lhovo/Netrol/Documents/Bill of Materials-NetTroll.xlsx

Comment | Description | Designator | Footprint | LibRef | Quantity | Manufacturer Part Number 1 | Supplier 1 | Supplier Part Number 1 | Supplier Stock 1 | Supplier Unit Price 1
NUF2230XV6T1G | 2 Line EMI Filter with ESD Protection, -40 to 85 degC, 6-Pin SOT-563, Pb-Free, Tape and Reel | U8, U9 | ONSC-SOT-563-6-463A-01_V | CMP-1066-00031-1 | 2 | NUF2230XV6T1G | Digi-Key | NUF2230XV6T1GOSDKR-ND | 2737 | 0.2728
ATmega328P-MUR | 8-bit AVR Microcontroller, 32KB Flash, 1KB EEPROM, 2KB SRAM, 32-pin MLF, Industrial Grade (-40°C to 85°C) | U1 | 32M1-A_N | ATmega328P-MUR | 1 | ATMEGA328P-MUR | Digi-Key | ATMEGA328P-MURCT-ND | 7953 | 3.445
NUF8402MNT4G | 8-Channel EMI Filter with Integrated ESD Protection, -40 to 85 degC, 16-Pin DFN, Pb-Free, Tape and Reel | U5, U6 | ONSC-DFN-16-506AC_V | CMP-1009-00001-1 | 2 | NUF8402MNT4G | Digi-Key | NUF8402MNT4GOSCT-ND | 1148 | 0.4092
Buck Converter | Adjustable Buck Converter Module | U7 | Buck_Module | Buck | 1
10pF | Capacitor (Semiconductor SIM Model) | C1, C2, C12, C13 | 0603 | Cap_10pF | 4 | CL10C100JC8NNNC | Digi-Key | 1276-2157-1-ND | 10504 | 0.0088
100nF | Capacitor (Semiconductor SIM Model) | C3, C4, C5, C6, C7, C8, C17, C18, C19, C20 | 0603 | Cap_100pF, Cap_100pF, Cap_100pF, Cap_100pF, Cap_100pF, Cap_100pF, Cap_100nF, Cap_100pF, Cap_100pF, Cap_100nF | 10 | C0603C104K4RACTU | Digi-Key | 399-1096-1-ND | 2381401 | 0.0101, 0.0101, 0.0101, 0.0101, 0.0101, 0.0101, 0.0156, 0.0101, 0.0101, 0.0156
4.7uF | Capacitor (Semiconductor SIM Model) | C10 | 0603 | Cap_4.7uF | 1 | CL10B475KQ8NQNC | Digi-Key | 1276-2087-1-ND | 73430 | 0.074
10nF | Capacitor (Semiconductor SIM Model) | C11, C16 | 0603 | Cap_10nF | 2 | C0603C103K5RACTU | Digi-Key | 399-1091-1-ND | 1564655 | 0.014
6.8nF | Capacitor (Semiconductor SIM Model) | C14, C15 | 0603 | Cap_6.8nF | 2 | CL10B682KB8SFNC | Digi-Key | 1276-2103-1-ND | 38764 | 0.0068
22uF | Capacitor (Semiconductor SIM Model) | C21 | 1210 | Cap_22uF | 1 | LMK325F226ZN-T | Digi-Key | 587-1395-1-ND | 9011 | 0.374
10uF | Capacitor (Semiconductor SIM Model) | C22, C23, C24 | 0603 | Cap_10uF | 3 | C1608X5R1E106M080AC | Digi-Key | 445-9015-1-ND | 130756 | 0.757
Diode | Default Diode | D4, D7, D9 | SOD-123 | Diode | 3 | MBRX120LF-TP | Digi-Key | MBRX120LF-TPMSCT-ND | 22264 | 0.2836
SMAJ58CA-TR | Default Diode | D8 | SMBJ | Diode_POWER | 1 | SMAJ58CA-TR | Digi-Key | 497-6509-1-ND | 11568 | 0.434
HD01-T | Diode Bridge | D1, D2 | MBS | Diode Bridge | 2 | HD01-T | Digi-Key | HD01DICT-ND | 89962 | 0.31
RJHSE-5384 | Ethernet Socket RJ45 With Leds | JP1 | RJHSE-5484 | Ethernet Socket | 1 | RJHSE-5384 | Digi-Key | RJHSE-5384-ND | 967 | 1.764
MMZ1608F030B | Ferrite Bead | FB1, FB2 | 0603 | Ferrite Bead | 2 | MMZ1608F030B | Digi-Key | 445-8676-1-ND | 14689 | 0.087
12V In/Out | Header, 2-Pin | JP4 | SCREWTERMINAL-3.5MM-2 | Header 2_ST | 1 | 1776275-2 | Digi-Key | A98036-ND | 49006 | 0.498
Common/NC | Header, 2-Pin | JP6 | SCREWTERMINAL-3.5MM-2 | Header 2_ST | 1 | 1776275-2 | Digi-Key | A98036-ND | 49006 | 0.498
GND/NO | Header, 2-Pin | JP8 | SCREWTERMINAL-3.5MM-2 | Header 2_ST | 1 | 1776275-2 | Digi-Key | A98036-ND | 49006 | 0.498
Selectable interrupt Via solder bridge | Header, 2-Pin | JP9 | SCREWTERMINAL-3.5MM-2 | Header 2_ST | 1 | 1776275-2 | Digi-Key | A98036-ND | 49006 | 0.498
Main Interrupt | Header, 2-Pin | JP12 | SCREWTERMINAL-3.5MM-2 | Header 2_ST | 1 | 1776275-2 | Digi-Key | A98036-ND | 49006 | 0.498
Relay Voltage Jumper | Header, 3-Pin | JP5 | 1X3 | Header 3 | 1 | M20-9990346 | Digi-Key | 952-2264-ND | 5963 | 0.132
Programming FTDI Header | Header, 6-Pin | JP2 | 1X6 | Header 6 | 1 | M20-9990646 | Digi-Key | 952-2270-ND | 6823 | 0.214
Optional External LED's | Header, 8-Pin | JP3 | 2X4 | Header 4x2 | 1 | M20-9760446 | Digi-Key | 952-1788-ND | 1636 | 0.28
Optional I/O | Header, 10-Pin, Dual row | JP7 | 2X10 | Header 10X2 | 1 | 302-S201 | Digi-Key | ED10524-ND | 509 | 0.42
TPS62112RSAT | IC REG BUCK SYNC 5V 1.5A 16QFN | U4 | 16-QFN | TPS62112RSAT | 1 | TPS62112RSAT | Digi-Key | 296-19717-1-ND | 11224 | 3.483
6.8uH | INDUCTOR WW 6.8UH 1.1A 1812 SMD | L1 | 1812 | INDUCTOR | 1 | LQH43CN6R8M03L | Digi-Key | 490-2518-1-ND | 304 | 0.426
10K | Isolated Resistor Network - Parts | R1, R3, R7 | SO8_S | Resistor_Pack_10K | 3 | 742C083103JP | Digi-Key | 742C083103JPCT-ND | 56827 | 0.069
100R | Isolated Resistor Network - Parts | R15 | SO8_S | Resistor_Pack_100R | 1 | 742C083101JP | Digi-Key | 742C083101JPCT-ND | 69745 | 0.069
BCX19 | NPN General Purpose | Q1 | SOT23-3 | BCX19 | 1 | BCX19LT1G | Digi-Key | BCX19LT1GOSCT-ND | 9124 | 0.207
AG8112 | POE Controller and Buck Converter | U3 | AG8100 | AG8100 | 1 | AG8112 | Fairmont Marketing | AG8112 | 5000 | 7.50
100uF | Polarized Capacitor (Surface Mount) | C9, C26 | PANASONIC_C | Cap_Polarized_100uF | 2 | EEE-HAJ101WAR | Digi-Key | PCE4718CT-ND | 2897 | 0.56
1000uF | Polarized Capacitor (Surface Mount) | C25 | PANASONIC_H13 | Cap_Polarized_1000uF | 1 | EEV-FK1E102Q | Digi-Key | PCE3462CT-ND | 361872 | 1.61
H2019FNLT | Power over Ethernet Magnetic Module | T1 | HXXXX | Magnetics | 1 | H2019FNLT | Mouser | 673-H2019FNLT | 610 | 7.51
LED-RGB_K | RED, GREEN, BLUE LED | D6 | RGB-CLVBAFKA | LED-RGB_K | 1 | CLVBA-FKA-CAEDH8BBB7A363 | Digi-Key | CLVBA-FKA-CAEDH8BBB7A363CT-ND | 11711 | 0.55
1M | Resistor | R2, R6, R20 | 0603 | Resistor_1M | 3 | AF0603FR-071ML | Digi-Key | 311-1MLMCT-ND | 4590 | 0.054
12K4 | Resistor | R4 | 0603 | Resistor_12K4 | 1 | RC1608F1242CS | Digi-Key | 1276-4752-1-ND | 1263 | 0.014
10K | Resistor | R5, R19, R21 | 0603 | Resistor_10K | 3 | RC0603JR-0710KL | Digi-Key | 311-10KGRCT-ND | 3996732 | 0.008
82R | Resistor | R8, R9 | 0603 | Resistor_82R | 2 | RC0603JR-0782RL | Digi-Key | 311-82GRCT-ND | 8364 | 0.008
10R | Resistor | R10 | 0603 | Resistor_10R | 1 | RC1608J100CS | Digi-Key | 1276-5014-1-ND | 189294 | 0.10
49R9 | Resistor | R11, R12 | 0603 | Resistor_49R9 | 2 | MCR03ERTF49R9 | Digi-Key | RHM49.9CFCT-ND | 136578 | 0.0084
220R | Resistor | R13, R14 | 0603 | Resistor_220R | 2 | RC0603JR-07220RL | Digi-Key | 311-220GRCT-ND | 771266 | 0.008
470R | Resistor | R22 | 0603 | Resistor_470R | 1 | RC0603JR-07470RL | Digi-Key | 311-470GRCT-ND | 668174 | 0.011
4K7 | Resistor | R23 | 0603 | Resistor_4K7 | 1 | RC0603JR-074K7L | Digi-Key | 311-4.7KGRCT-ND | 4295372 | 0.011
G5V-1-DC12 | Single-Pole Dual-Throw Relay | K1 | G5V-1 | Relay-SPDT | 1 | G5V-1-DC12 | Digi-Key | Z774-ND | 18767 | 2.05
16MHz | Surface Mount Quartz Crystal | Y1 | CRYSTAL-SMD-2.5X2-ABM10 | Crystal_16MHz | 1 | CX2520DB16000D0GEJCC | Digi-Key | 1253-1122-1-ND | 0 | 0.774
25MHz | Surface Mount Quartz Crystal | Y2 | CRYSTAL-SMD-2.5X2-ABM10 | Crystal_25MHz | 1 | ABM10-25.000MHZ-E20-T | Digi-Key | 535-9095-1-ND | 10901 | 1.469
EVQ-Q2B03W | Switch | S1 | TACTILE_SWITCH_SMD | SW-PB | 1 | EVQ-Q2B03W | Digi-Key | P12932SCT-ND | 18730 | 0.374
LED | Typical RED, GREEN, YELLOW, AMBER GaAs LED | D3, D5 | LED-0603 | LED | 2 | LG Q971-KN-1 | Mouser | 720-LGQ971-KN-1 | 126029 | 0.082
UA78M33 3V3 Reg | Voltage Regulator | VR1 | SOT223 | Volt Reg | 1 | UA78M33CDCY | Digi-Key | 296-27140-5-ND | 1360 | 0.525
Wiznet-W5500 | W5500 Fast SPI Ethernet Controller | U2 | QFN48 | Wiznet-W5500 | 1 | W5500 | Digi-Key | 1278-1021-ND | 3075 | 4.725
