lhovo/Netrol/Documents/Schematic.PDF

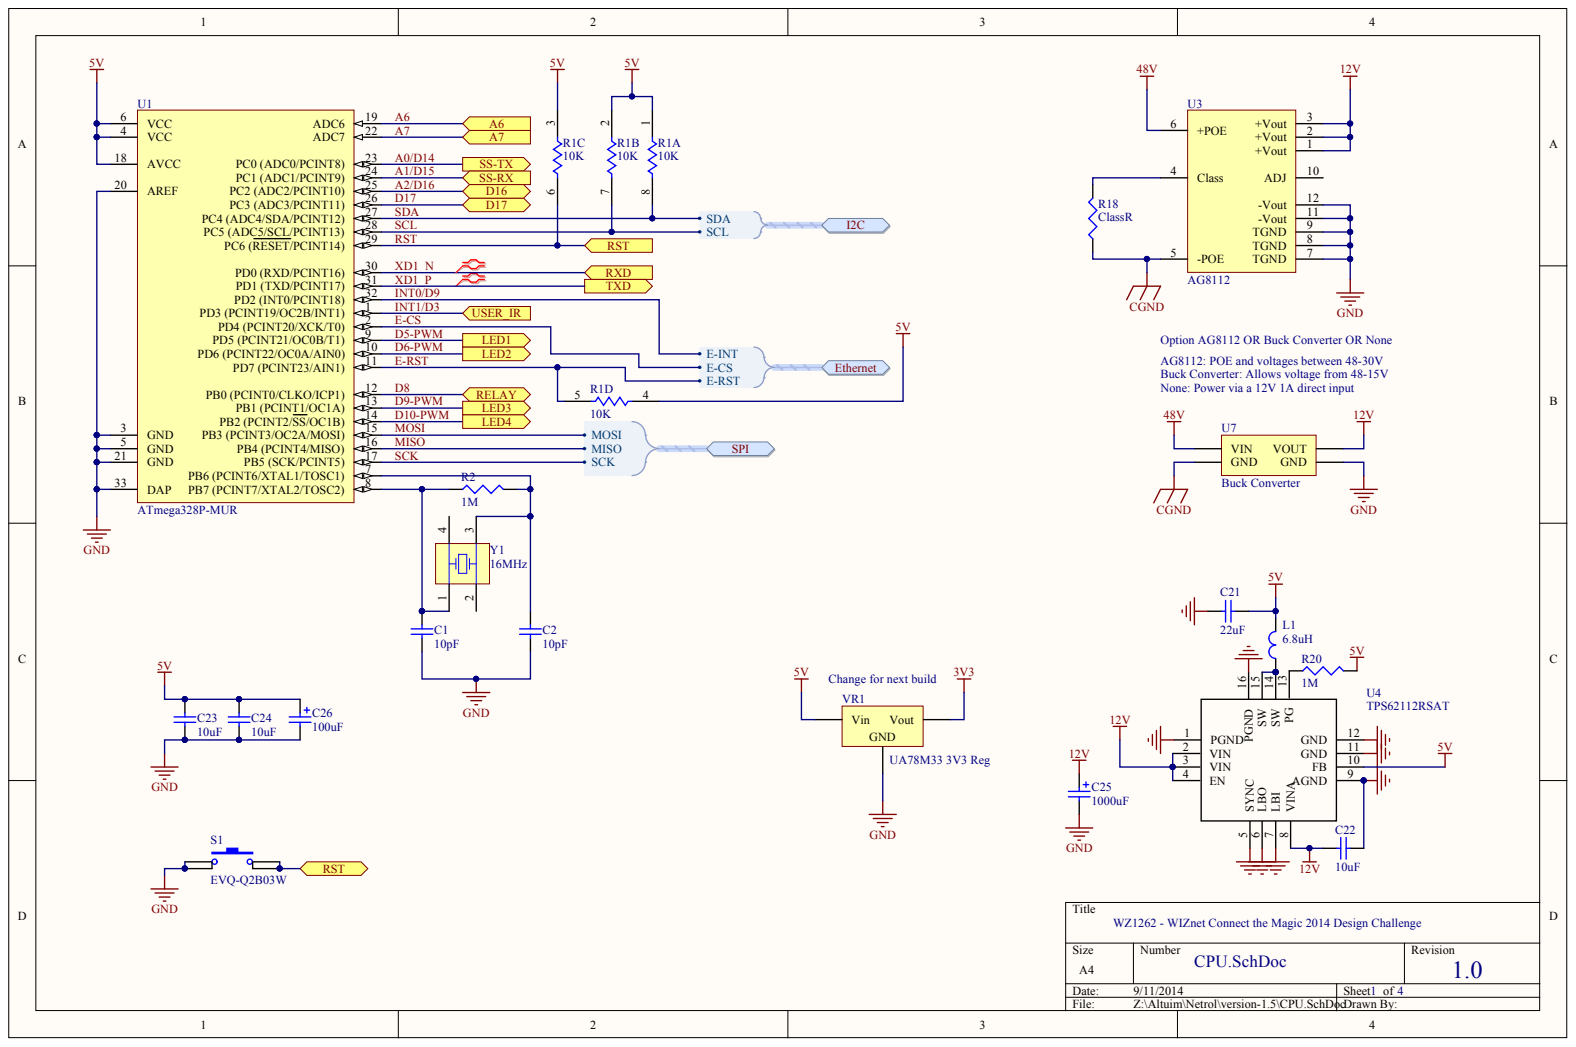
[picture p1: page 1]

Option AG8112 OR Buck Converter OR None
AG8112: POE and voltages between 48-30V
Buck Converter: Allows voltage from 48-15V
None: Power via a 12V 1A direct input

PG 13 SW 14 SW 15 PGND 16

WZ1262 - WIZnet Connect the Magic 2014 Design Challenge 1 Size A4 | 4 Number | Revision 1.0 CPU.SchDoc

Date: 9/11/2014 | Sheet of
File: Z:\Altuim\Netrol\version-1.5\CPU.SchDocDrawn By:

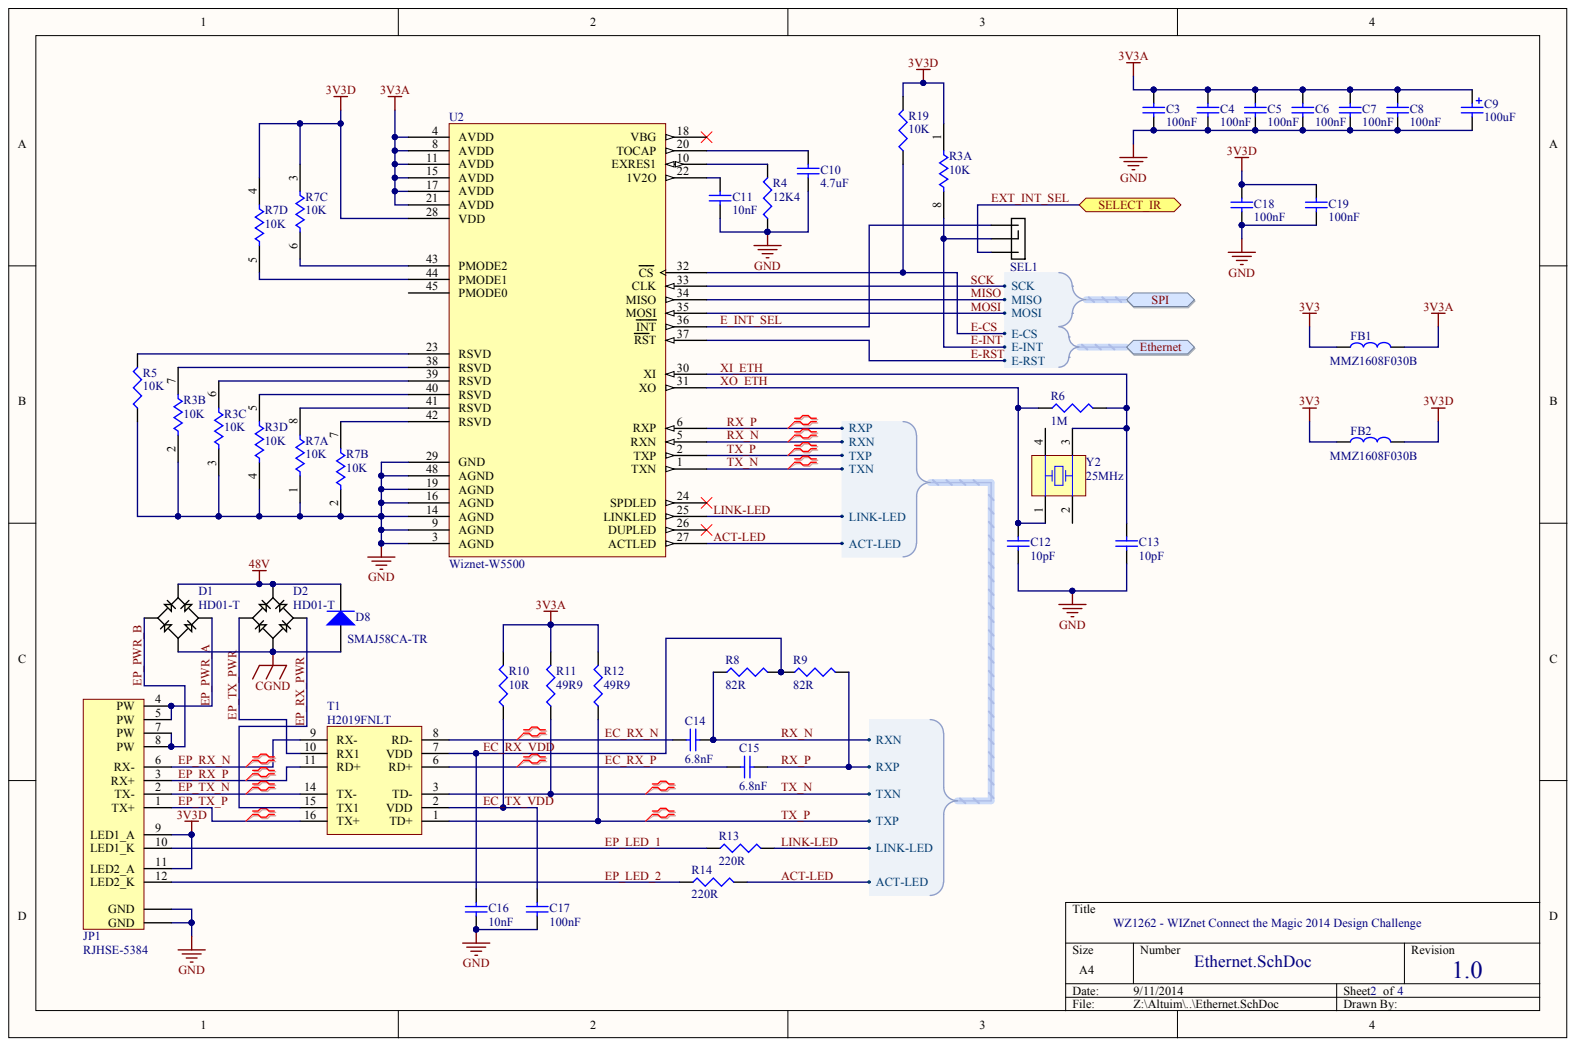
[picture p2: page 2]

AVDD 15

AVDD 21 | | C11 12K4 10nF

SCK
MISO
MOSI
E-CS
E-INT

E_INT_SEL

RSVD 40

XO_ETH

RSVD 42

5 RXP 6 | RX_P RXP

1 TXP 2

EP_RX_N | | | RX1 10 | 7 | EC_RX_VDD

3 | EP_RX_P | | | TX- 14 | 3 2 | EC_TX_VDD

1 EP_TX_P | | TX1 15
3V3D | TX+ 16

WZ1262 - WIZnet Connect the Magic 2014 Design Challenge 2 Size A4 | 4 Number | Revision 1.0 Ethernet.SchDoc

Date: 9/11/2014 | Sheet of
File: Z:\Altuim\..\Ethernet.SchDoc | Drawn By:

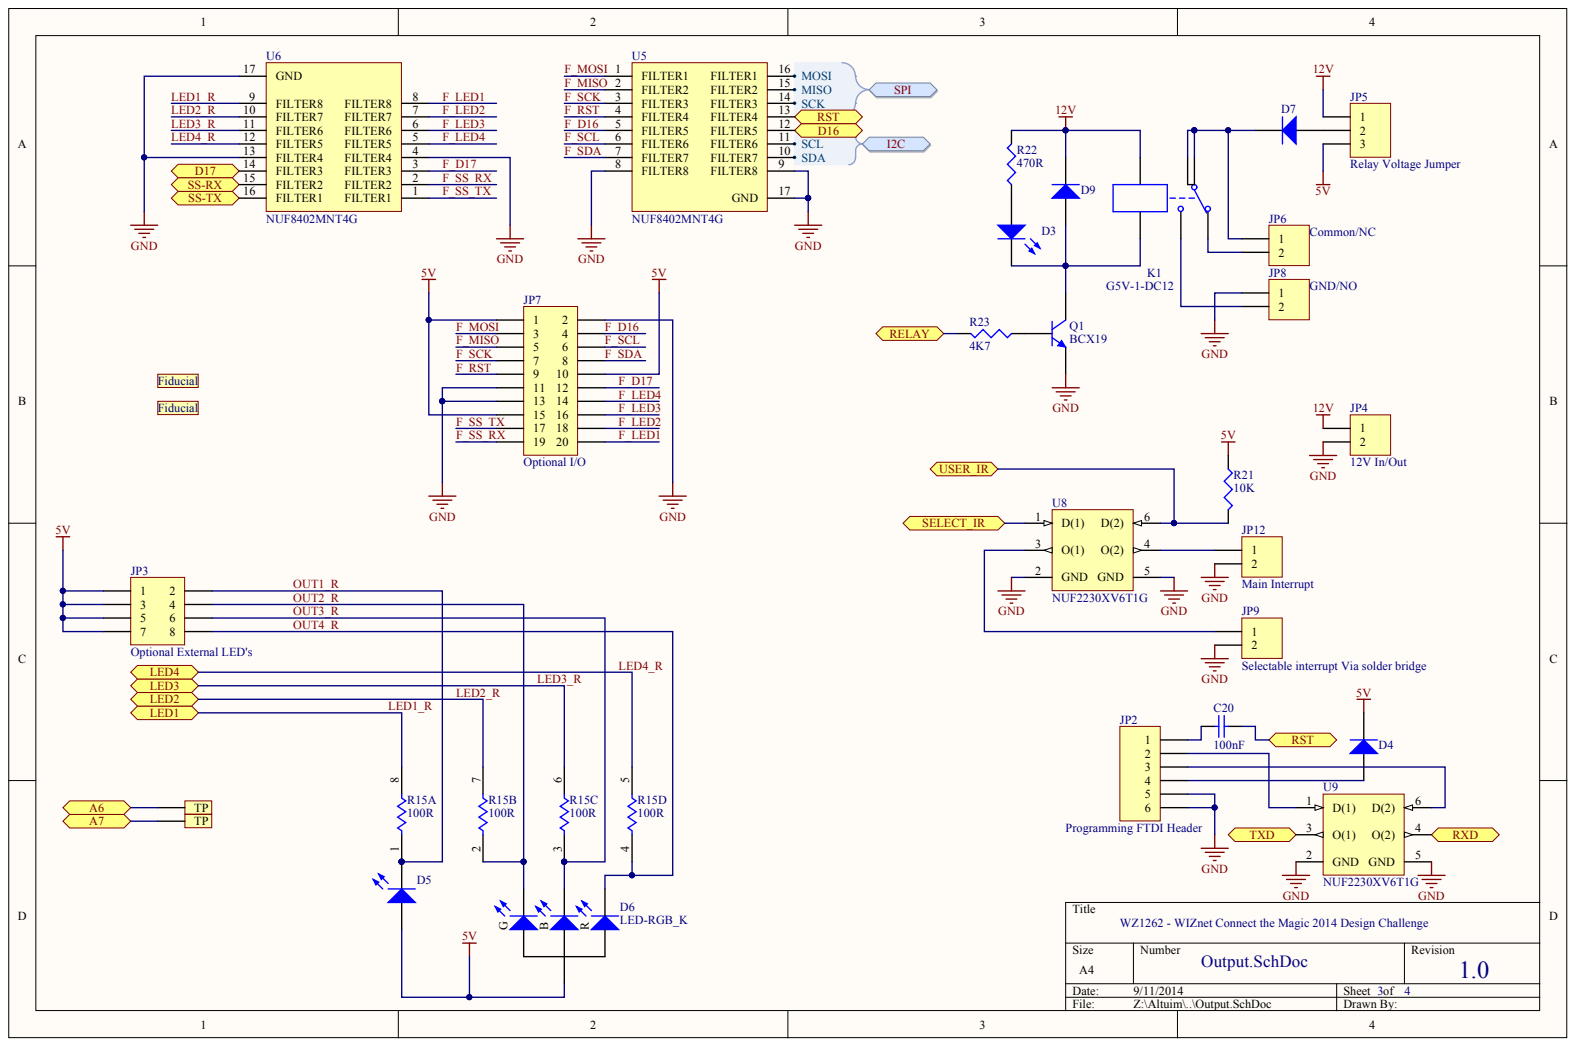
[picture p3: page 3]

D17 SS-RX SS-TX | FILTER3 14 | F_D17

FILTER2 15 | F_SS_RX
FILTER1 16 | F_SS_TX

LED3_R

LED1_R

LED2_R

WZ1262 - WIZnet Connect the Magic 2014 Design Challenge

Size A4 | Number | Revision 1.0 Output.SchDoc

Date: 9/11/2014 | Sheet of 3 4
File: Z:\Altuim\..\Output.SchDoc | Drawn By:

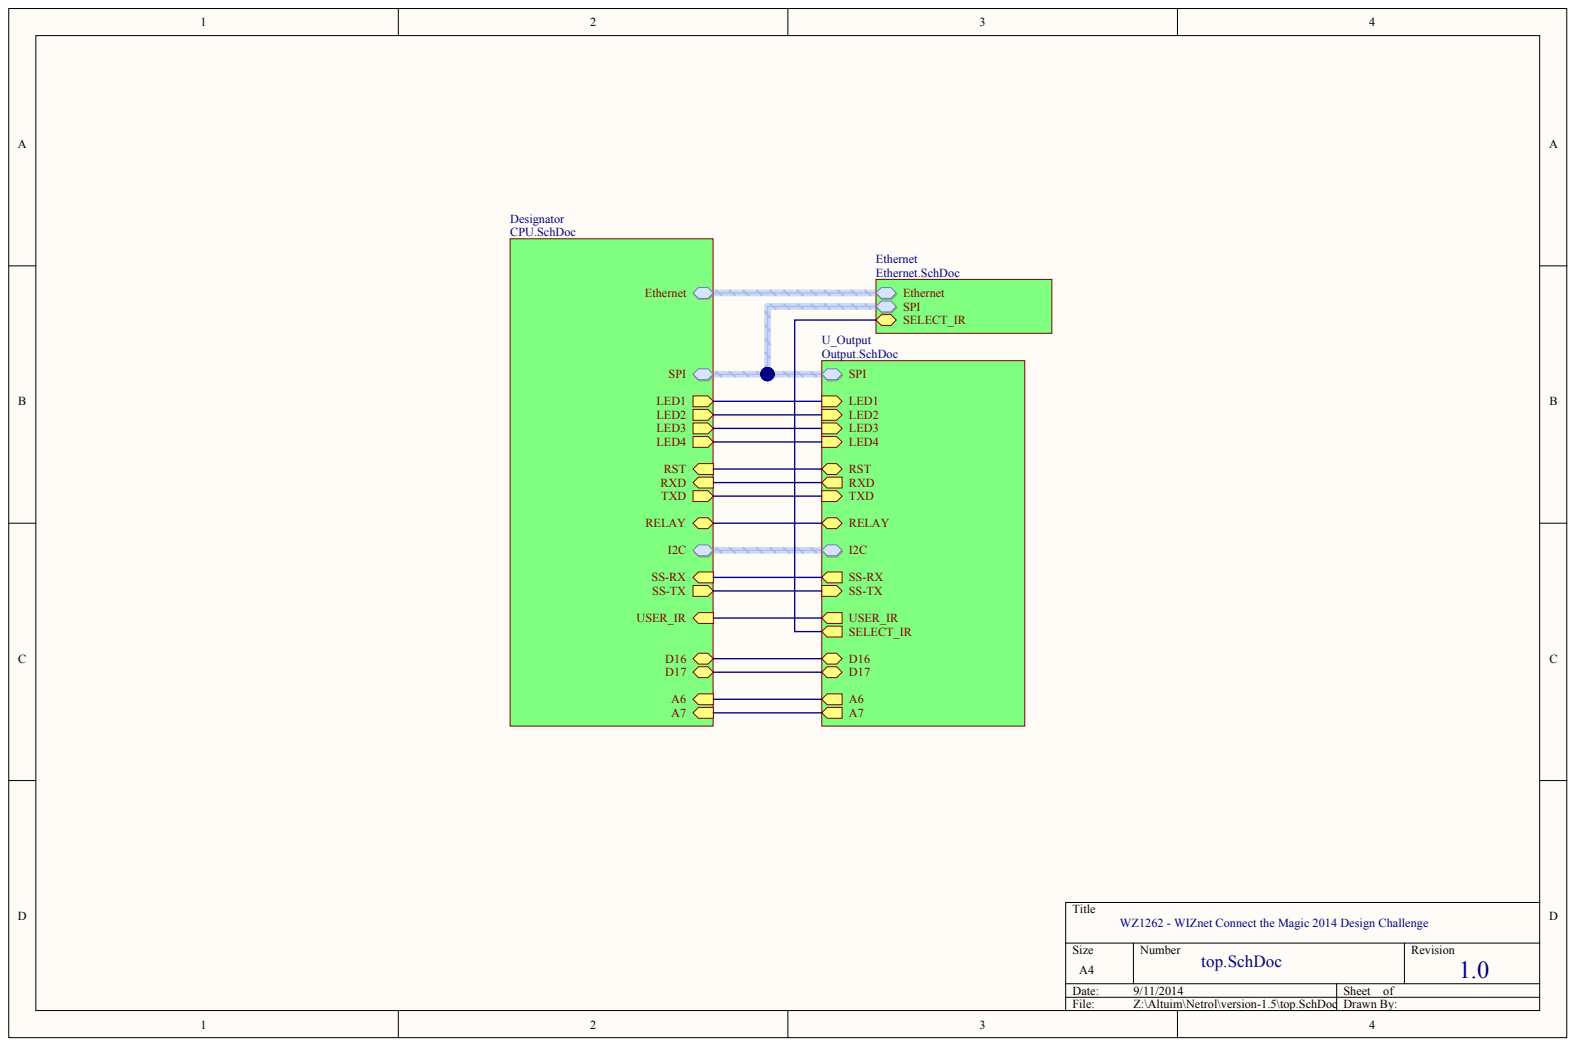
[picture p4: page 4]

WZ1262 - WIZnet Connect the Magic 2014 Design Challenge

Size A4 | Number | Revision 1.0 top.SchDoc

Date: 9/11/2014 | Sheet of
File: Z:\Altuim\Netrol\version-1.5\top.SchDoc | Drawn By:
