lhovo/Netrol/Documents/Assembly Drawings.PDF

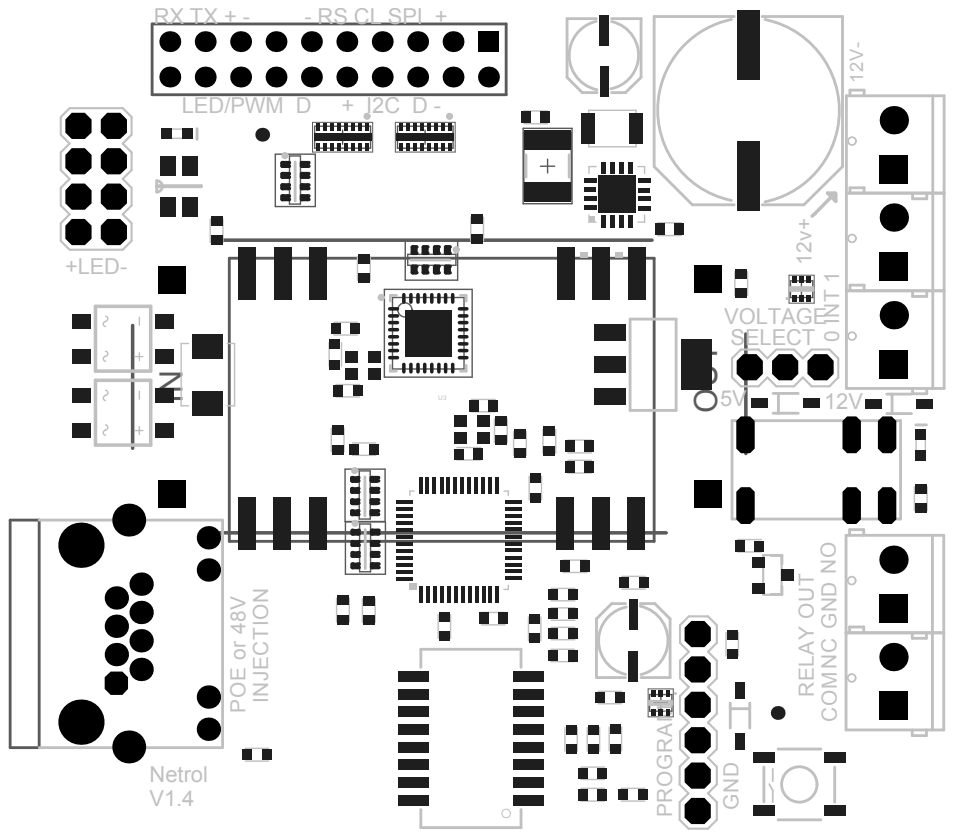
[picture p5: page 1]

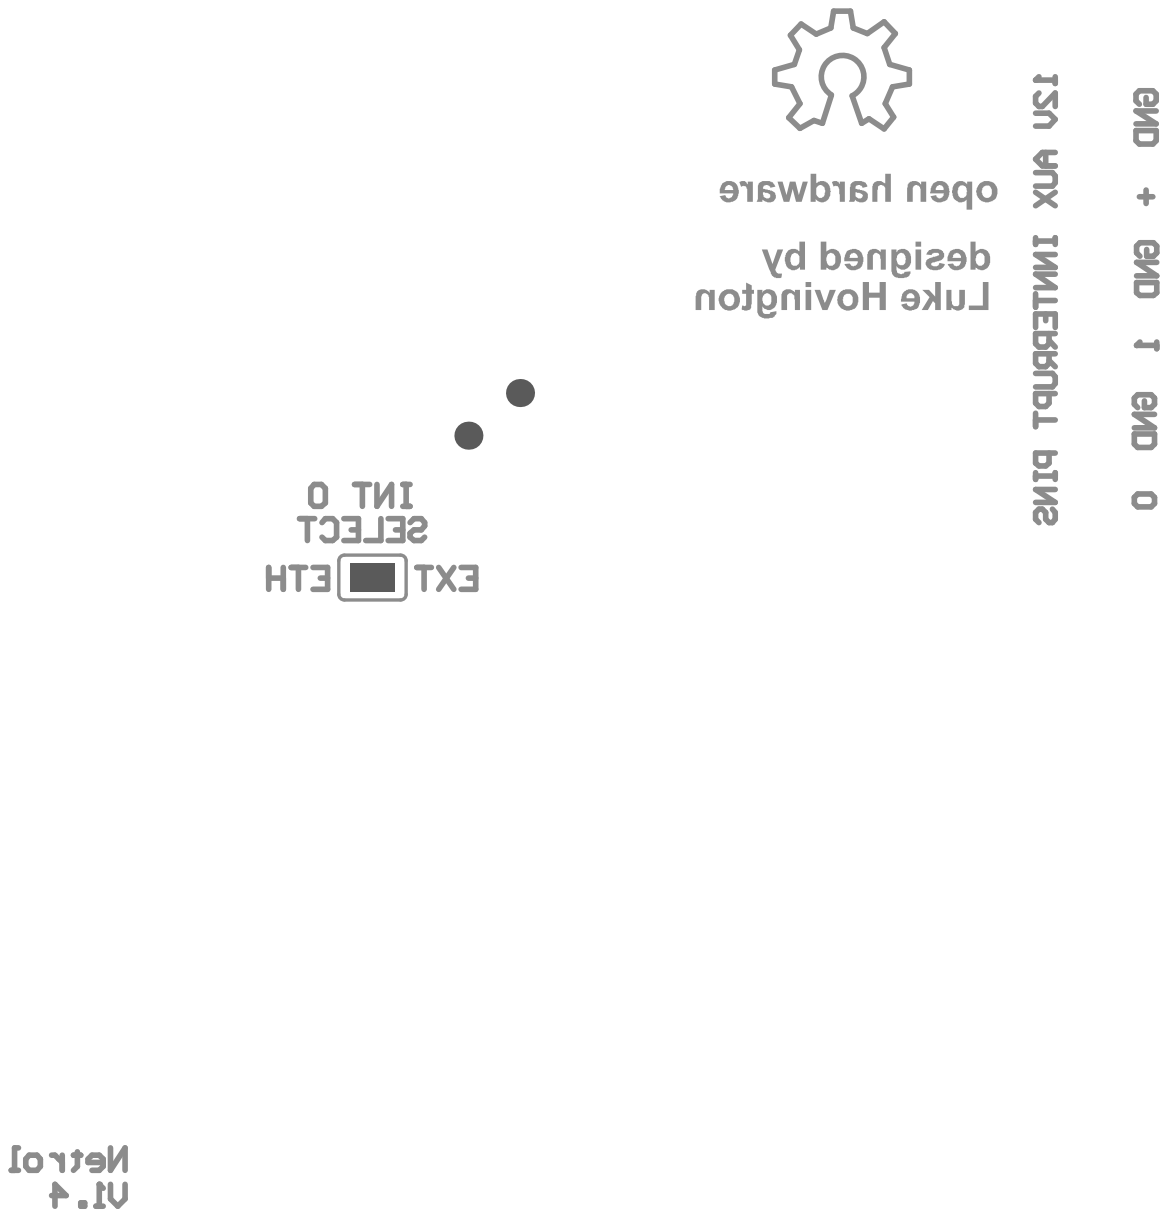
[picture p6: page 2]
