lhovo/Netrol/Documents/PCB Prints.PDF

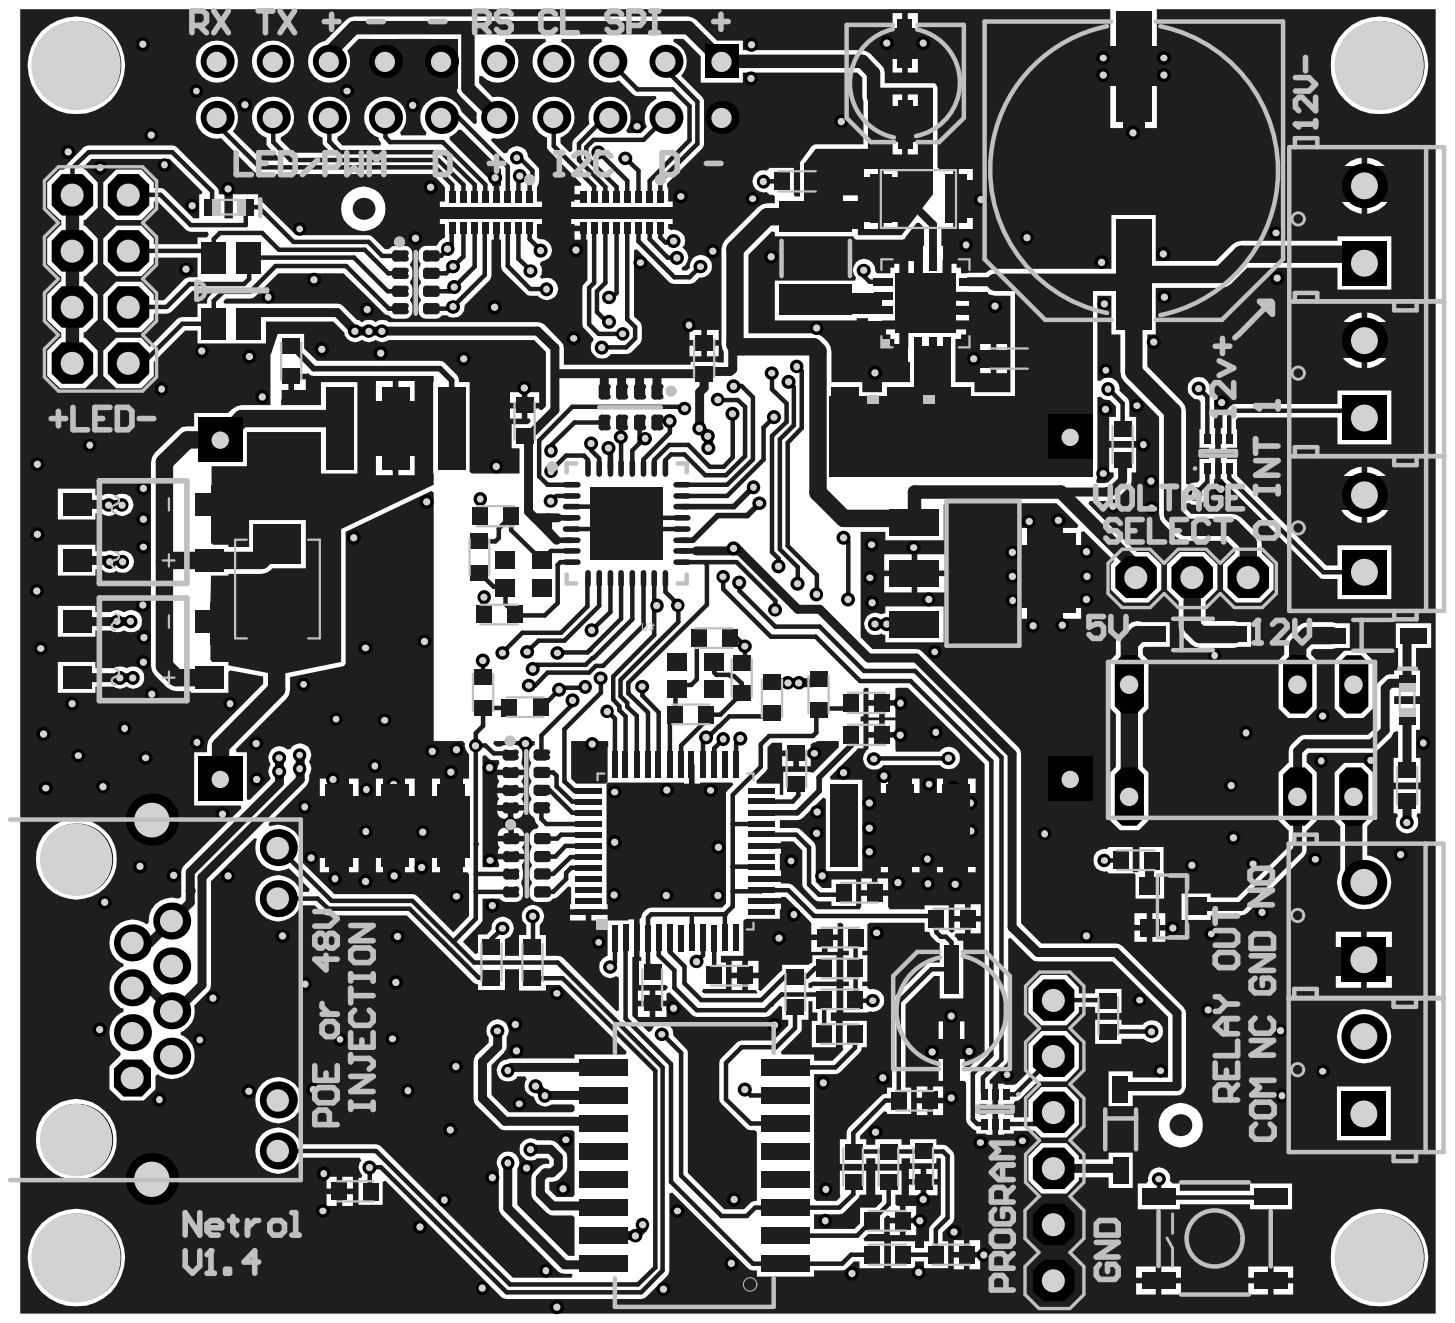
[picture p7: page 1]

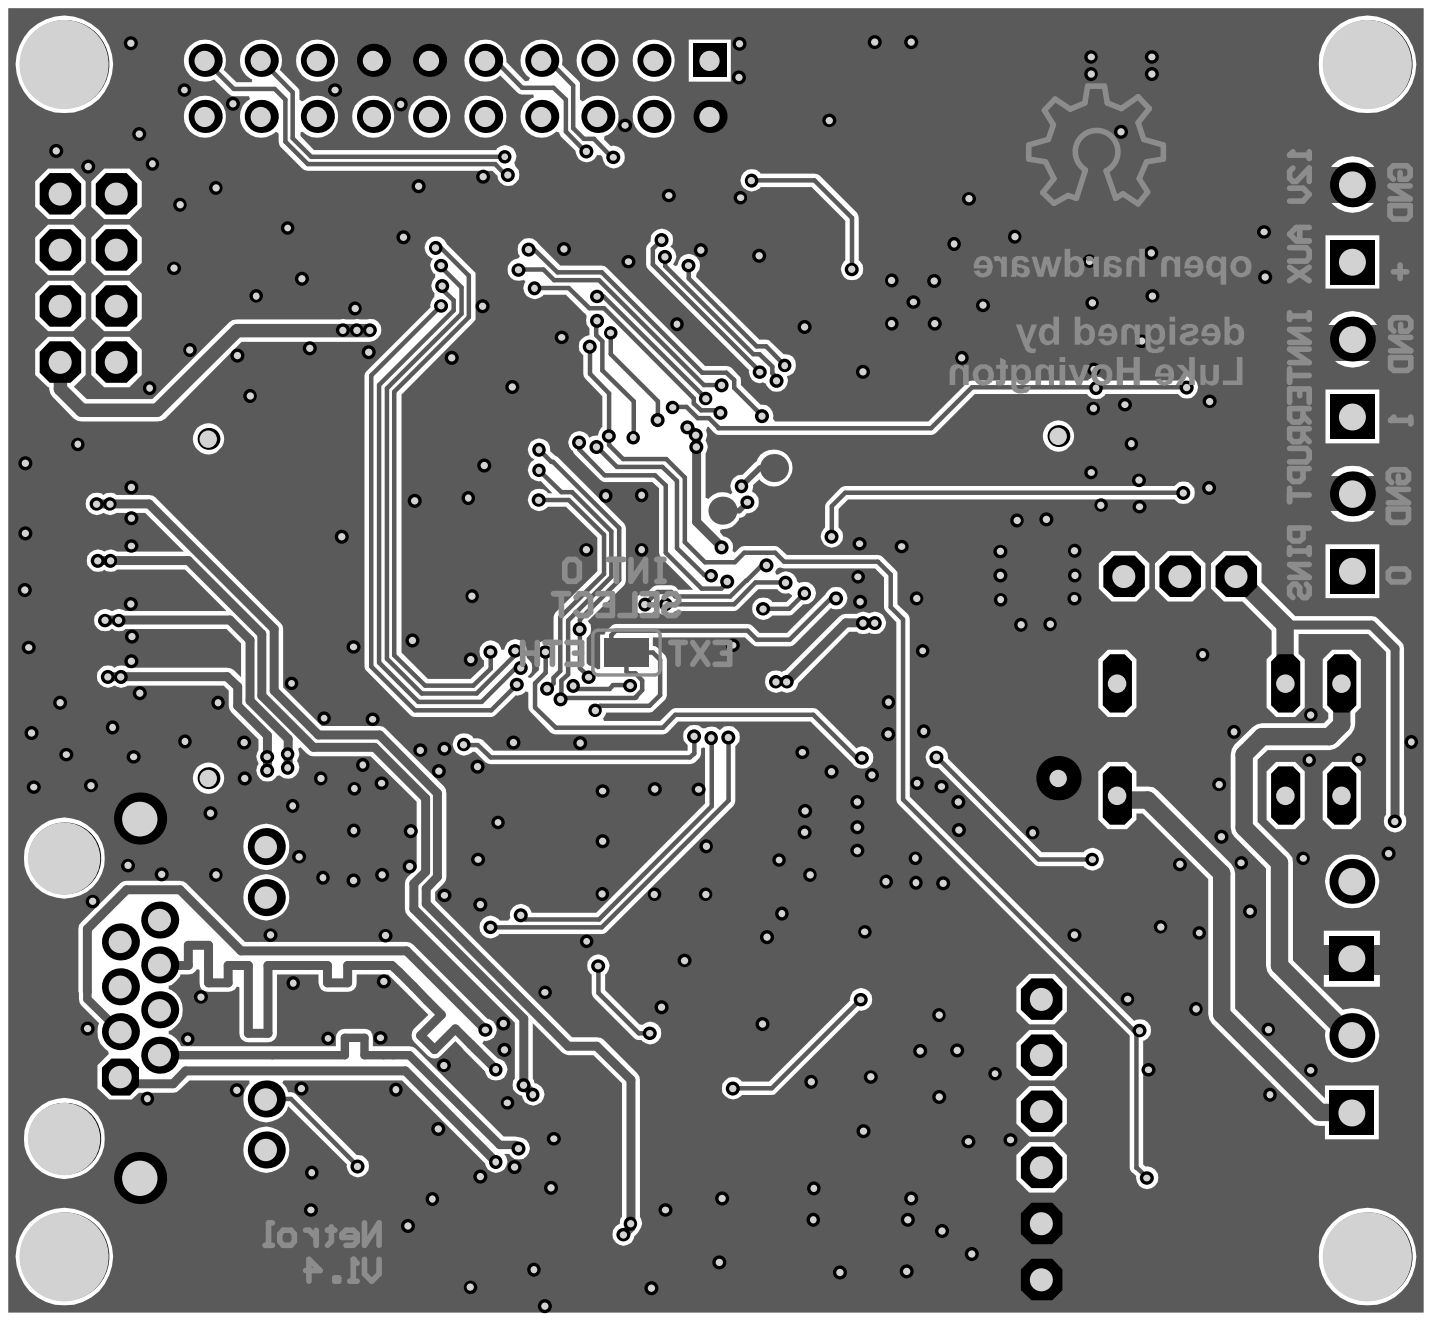
[picture p8: page 2]
