lhovo/Netrol/(list of files, drawings)

Other design files:
PCB/CPU.SchDoc
PCB/Ethernet.SchDoc
PCB/NetTroll.PcbDoc
PCB/NetTroll.PcbLib
PCB/NetTroll.PrjPcb
PCB/NetTroll.SchLib
PCB/Output.SchDoc
PCB/Power.SchDoc
PCB/top.SchDoc
