lhovo/Netrol/(commit log)

2014-10-02 Finished most mod's Added filters on the input pins Moved bits around to get all holes on the outer edge of the board Updated some parts with 3d body to render nicely on the 3d board view
    [CPU.SchDoc, Ethernet.SchDoc, NetTroll.PcbDoc, NetTroll.PcbLib, NetTroll.PrjPcb, NetTroll.SchLib, Output.SchDoc, Power.SchDoc]
2016-02-03 Adding bom and change of board
    [Bill of Materials-NetTroll.xlsx, NetTroll.PrjPcb, Output.SchDoc]
